mosaeed46/assistive-robotic-gripper/docs/bill-of-materials.md

# Bill of Materials

| Component | Quantity |
| --- | ---: |
| Arduino Uno | 1 |
| Continuous-rotation servo | 1 |
| Push button | 1 |
| 10 kΩ resistor | 1 |
| Breadboard | 1 |
| AA batteries | 3 |
| Battery holder | 1 |
| Jumper wires | approximately 15 |
| 3D-printed PLA components | 0.24167 kg |
| Adjustable hook-and-loop strap | 0.75 m |
| High-friction grip material | 3 pieces |
| Pull rings | 2 |

The recorded prototype material and component value was approximately **$73 CAD**.
