mosaeed46/assistive-robotic-gripper/assets/printing-summary.jpg

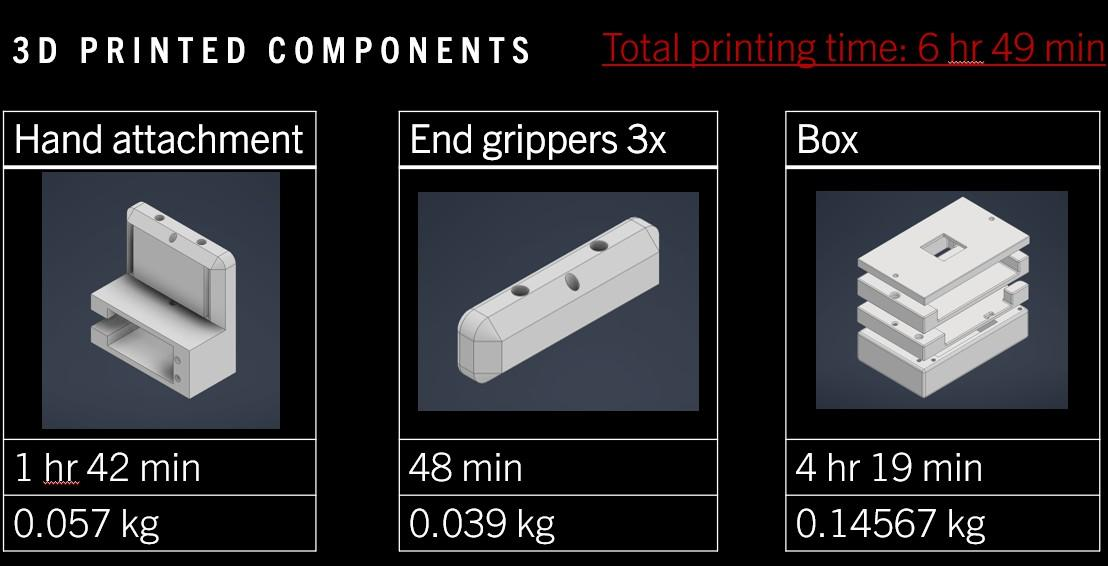
assets/printing-summary.jpg
